bellTanTan/pc8031fabgl/img/022.jpg

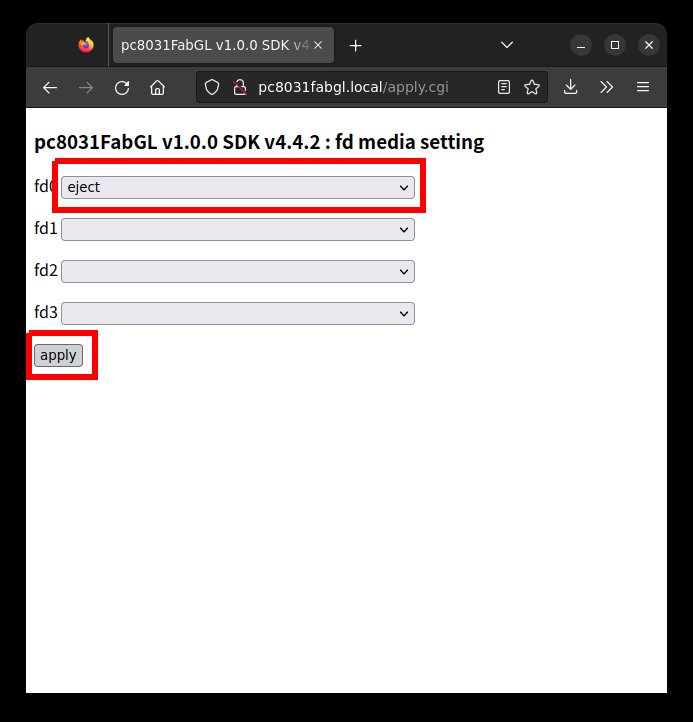
img/022.jpg
