bellTanTan/pc8031fabgl/src/machine.h

/*
  Created by tan (trinity09181718@gmail.com)
  Copyright (c) 2022 tan
  All rights reserved.

  This program is based on FabGL/examples/VGA/Altair8800/src/machine.h and
  FabGL/examples/VGA/PCEmulator/machine.h
  (http://www.fabglib.org/)

* Please contact trinity09181718@gmail.com if you need a commercial license.
* This software is available under GPL v3.

* This library and related software is available under GPL v3.

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
  You should have received a copy of the GNU General Public License
  along with FabGL.  If not, see <http://www.gnu.org/licenses/>.
 */


#pragma once

#include <stdint.h>
#include <stdio.h>
#include <string.h>
#include <time.h>
#include <utime.h>
#include <sys/time.h>
#include <sys/utime.h>
#include <WiFi.h>
#include <WiFiClient.h>
#include <WebServer.h>
#include <ESPmDNS.h>

#include "freertos/FreeRTOS.h"
#include "freertos/task.h"
#include "esp_int_wdt.h"

#include "fabgl.h"
#include "fabutils.h"
#include "emudevs/Z80.h"

using namespace fabgl;

#include "emu.h"
#include "version.h"
#include "DISK.h"

extern  WebServer     webServer;
extern  void webHandleRoot( void );
extern  void webHandleApply( void );
extern  void webHandleNotFound( void );


////////////////////////////////////////////////////////////////////////////////////
// Machine


class Machine
{
public:
  typedef struct {
    char *  name;
    time_t  tLastWrite;
  } DIRLIST , *PDIRLIST;

  Machine();

  ~Machine();

  int init( void );
  void initShiftInOut( void );
  void initWifi( void );
  void backGround( void );

  bool getDiskRomEnable( void )               { return m_diskRomEnable; }
  bool get2kRomLoaded( void )                 { return m_DISK.get2kRomLoaded(); }
  void shiftOutput( uint16_t value )          { m_DISK.shiftOutput( value ); }

  void setFdSettingComplete( void )
  {
    m_wifiTimer         = millis();
    m_wifiStatusLed     = HIGH;
    m_ledFlickerCount   = 20;
    m_fdSettingComplete = true;
  }

  bool setDiskImage( int drive, bool writeProtected, const char * imgFileName );
  const char * getDiskImageFileName( int drive );  

  void outputSystemStatusLed( int value );
  void eventWebHandleRoot( void );
  bool eventWebHandleApply( void );
  void eventWebHandleNotFound( void );

  void outputBootMessage( void )
  {
    _MSG_PRINT( "\r\nboot\r\n%s\r\n", m_version );
#ifdef ESP_ARDUINO_VERSION
    _MSG_PRINT( "ESP_ARDUINO_VERSION(0x%04X)\r\n", ESP_ARDUINO_VERSION );
#endif // ESP_ARDUINO_VERSION
    _MSG_PRINT( "FABGL_ESP_IDF_VERSION(0x%04X)\r\n", FABGL_ESP_IDF_VERSION );
  }

  void outputFreeHeapMessage( void )
  {
    _MSG_PRINT( "Internal Total Heap %d bytes\r\n", ESP.getHeapSize() );
    _MSG_PRINT( "Internal Free  Heap %d bytes\r\n", ESP.getFreeHeap() );
  }

private:
  void wifiMain( void );
  void checkWifiRssi( void );
  bool listDir( void );
  void freeDir( void );
  static int qsortComp( const void * p0, const void * p1 );
#ifdef _USED_SPIFFS
  bool updateSpiffsFileDateTime( void );
  time_t getFileDateTime( uint8_t * binBuf, const char * pszPath );
#endif // _USED_SPIFFS

#ifdef _DEBUG
  void debugHelp( void );
  void debugCommand( void );
#endif // _DEBUG

  SoundGenerator  m_soundGenerator;         // fabgl library : class SoundGenerator
                                            // floppy disk 0 ~ 3 image file name (*.D88)
  char            m_fdImgFileName[MAX_DRIVE][256];
  bool            m_diskRomEnable;          // flag : floppy disk rom enable
  DISK            m_DISK;                   // PC-80S31 (=PC-8801mkII SR/FR DISK.ROM 2Kbytes)

#ifdef _DEBUG
  char            m_serialRecvBuf[64];      // debug command Serial recive buffer
  int             m_serialRecvIndex;        // debug command Serial recive buffer index
  int             m_lastDumpDiskIoInAdrs;   // debug command Floppy DISK uint I/O input port last adderss
  int             m_lastDumpDiskIoOutAdrs;  // debug command Floppy DISK uint I/O output port last adderss
  int             m_lastDumpDiskMemoryAdrs; // debug command Floppy DISK uint Memory dump last adderss
  QueueHandle_t   m_queueHandle;            // queue handle
#endif // _DEBUG

  int             m_diskDirListCount;       // d88 file list count
  PDIRLIST        m_diskDirList;            // d88 file list

  int             m_wifiSeqNo;              // wifi sequence no
  int             m_wifiStatusLed;          // wifi led status
  int             m_wifiConnectCheckCnt;    // wifi connect check counter
  int             m_wifiTimer;              // wifi connect check timer
  int             m_ledFlickerCount;        // system status led flicker count
  bool            m_fdSettingComplete;      // flag : fd setting complete

  char            m_version[64];            // version
};
