bellTanTan/pc8031fabgl/src/media.cpp

/*
  Created by tan (trinity09181718@gmail.com)
  Copyright (c) 2022-2023 tan
  All rights reserved.

* Please contact trinity09181718@gmail.com if you need a commercial license.
* This software is available under GPL v3.

* This library and related software is available under GPL v3.

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
  You should have received a copy of the GNU General Public License
  along with FabGL.  If not, see <http://www.gnu.org/licenses/>.
 */

#include "media.h"


media::media()
{
  m_d88Type        = false;
  m_writeProtected = false;
  m_inserted       = false;
  m_mediaType      = MEDIA_TYPE_UNKNOWN;
  m_driveMfm       = false;
  m_fileSize       = 0;
  m_sectorSize     = 0;
  m_deleted        = false;
  m_crcError       = false;
  m_driveMfm       = false;

  m_d88FileHeader = NULL;
  m_d88rwBuffer   = NULL;
  m_sectorBuffer  = NULL;
  m_formatData    = NULL;
  m_formatMemSize = 0;
  m_formatSeekPos = 0;

  memset( m_imgFileName,  0, sizeof( m_imgFileName ) );
}


media::~media()
{
}


bool media::setSectorBuffer( uint8_t * d88rwBuffer )
{
  m_d88rwBuffer  = d88rwBuffer;
  m_sectorBuffer = &m_d88rwBuffer[16];
  size_t size = sizeof( *m_d88FileHeader );
  m_d88FileHeader = (PD88_FILE_HEADER)malloc( size );
  if ( !m_d88FileHeader ) return false;
  memset( m_d88FileHeader, 0, size );
  return true;
}


bool media::insert( bool writeProtected, const char * imgFileName )
{
  m_d88Type        = false;
  m_writeProtected = false;
  m_inserted       = false;
  m_mediaType      = MEDIA_TYPE_UNKNOWN;
  m_driveMfm       = false;
  m_fileSize       = 0;
  m_sectorSize     = 0;
  m_deleted        = false;
  m_crcError       = false;
  m_driveMfm       = false;
  if ( !imgFileName ) return false;
  memset( m_d88FileHeader, 0, sizeof( *m_d88FileHeader ) );
  char * p = strrchr( imgFileName, '.' );
  if ( !p ) return false;
  if ( strcasecmp( p, D88_FILE_EXTENSION ) != 0 ) return false;
  auto fp = fopen( imgFileName, "r" );
  if ( !fp ) return false;
  fseek( fp, 0, SEEK_END );
  size_t fileSize = ftell( fp );
  fseek( fp, 0, SEEK_SET );
  size_t result = fread( m_d88FileHeader, 1, sizeof( *m_d88FileHeader ), fp );
  fclose( fp );
  if ( result != sizeof( *m_d88FileHeader ) ) return false;
  if ( m_d88FileHeader->diskType != MEDIA_TYPE_2D ) return false;
  if ( m_d88FileHeader->diskSize != 348848 ) return false;
  if ( fileSize != 348848 ) return false;
  memset( m_imgFileName, 0, sizeof( m_imgFileName ) );
  strcpy( m_imgFileName, imgFileName );
  if ( m_d88FileHeader->writeProtect )
    m_writeProtected = true;
  else
    m_writeProtected = writeProtected;
  m_d88Type    = true;
  m_inserted   = true;
  m_ejected    = false;
  m_mediaType  = MEDIA_TYPE_2D;
  m_driveMfm   = true;
  m_fileSize   = fileSize;
  m_sectorSize = 256;
  m_deleted    = false;
  m_crcError   = false;
  return true;
}


void media::eject( void )
{
  m_d88Type        = false;
  m_inserted       = false;
  m_ejected        = true;
  m_writeProtected = false;
  m_mediaType      = MEDIA_TYPE_UNKNOWN;
  m_driveMfm       = false;
  m_fileSize       = 0;
  m_sectorSize     = 0;
  m_deleted        = false;
  m_crcError       = false;
  memset( m_imgFileName, 0, sizeof( m_imgFileName ) );
}


bool media::readSector( int cylinder, int head, int sectorNo, int sectorLen )
{
  if ( !( m_d88Type && m_inserted && m_mediaType == MEDIA_TYPE_2D && sectorLen == 1 ) ) return false;
  if ( !( cylinder >= 0 && cylinder <= 39 ) ) return false;
  if ( !( head >= 0 && head <= 1 ) )          return false;
  if ( !( sectorNo >= 1 && sectorNo <= 16 ) ) return false;
  int d88SectorSize = 16 + m_sectorSize;
  int logicalTrack = ( cylinder * 2 ) + head;
  int seekPos = sizeof( D88_FILE_HEADER )
              + ( d88SectorSize * 16 * logicalTrack )
              + ( d88SectorSize * ( sectorNo - 1 ) );
  int sectorPos = m_d88FileHeader->trackTable[cylinder]
                + ( d88SectorSize * 16 * cylinder )
                + ( d88SectorSize * 16 * head )
                + ( d88SectorSize * ( sectorNo - 1 ) );
  if ( seekPos != sectorPos ) return false;
  if ( seekPos > m_fileSize ) return false;
  auto fp = fopen( m_imgFileName, "r" );
  if ( !fp ) return false;
  bool sectorRead = false;
  fseek( fp, seekPos, SEEK_SET );
  size_t result = fread( &m_d88rwBuffer[0], 1, d88SectorSize, fp );
  if ( result == d88SectorSize )
    sectorRead = true;
  else
    m_crcError = true;
  fclose( fp );
  return sectorRead;
}


bool media::writeSector( int cylinder, int head, int sectorNo, int sectorLen )
{
  if ( !( m_d88Type && m_inserted && m_mediaType == MEDIA_TYPE_2D && sectorLen == 1 ) ) return false;
  if ( !( cylinder >= 0 && cylinder <= 39 ) ) return false;
  if ( !( head >= 0 && head <= 1 ) )          return false;
  if ( !( sectorNo >= 1 && sectorNo <= 16 ) ) return false;
  int d88SectorSize = 16 + m_sectorSize;
  int logicalTrack = ( cylinder * 2 ) + head;
  int seekPos = sizeof( D88_FILE_HEADER )
              + ( d88SectorSize * 16 * logicalTrack )
              + ( d88SectorSize * ( sectorNo - 1 ) );
  int sectorPos = m_d88FileHeader->trackTable[cylinder]
                + ( d88SectorSize * 16 * cylinder )
                + ( d88SectorSize * 16 * head )
                + ( d88SectorSize * ( sectorNo - 1 ) );
  if ( seekPos != sectorPos ) return false;
  if ( seekPos > m_fileSize ) return false;
  auto fp = fopen( m_imgFileName, "r+" );
  if ( !fp ) return false;
  bool sectorWrite = false;
  fseek( fp, seekPos, SEEK_SET );
  size_t result = fwrite( &m_d88rwBuffer[0], 1, d88SectorSize, fp );
  if ( result == d88SectorSize )
    sectorWrite = true;
  else
    m_crcError = true;
  fclose( fp );
  return sectorWrite;
}


bool media::formatTrackBegin( int cylinder, int head, int sectorNoMax )
{
  if ( !( m_d88Type && m_inserted && m_mediaType == MEDIA_TYPE_2D && sectorNoMax == 16 ) ) return false;
  if ( !( cylinder >= 0 && cylinder <= 39 ) ) return false;
  if ( !( head >= 0 && head <= 1 ) )          return false;
  if ( !m_formatData )
  {
    m_formatMemSize = (16 + 256) * sectorNoMax;
    m_formatData = (uint8_t *)malloc( m_formatMemSize );
    if ( !m_formatData )
    {
      _UPD765A_DEBUG_PRINT( "uPD765A %s(%d) malloc(%d) fail\r\n", __func__, __LINE__, m_formatMemSize );
      return false;
    }
  }
  m_formatSeekPos = 0;
  _UPD765A_DEBUG_PRINT( "uPD765A %s(%d) '%s'\r\n", __func__, __LINE__, m_imgFileName );
  return true;
}


void media::formatTrackEnd( void )
{
  if ( m_formatMemSize == 0 || m_formatSeekPos == 0 )
    return;
#ifdef _UPD765A_DEBUG
  uint32_t t0 = micros();
#endif // _UPD765A_DEBUG
  auto fp = fopen( m_imgFileName, "r+" );
  if ( !fp ) return;
  fseek( fp, m_formatSeekPos, SEEK_SET );
  size_t result = fwrite( m_formatData, 1, m_formatMemSize, fp );
  if ( result != m_formatMemSize )
    _UPD765A_DEBUG_PRINT( "uPD765A %s(%d) fwrite fail\r\n", __func__, __LINE__ );
  fclose( fp );
#ifdef _UPD765A_DEBUG
  uint32_t t1 = micros();
  int dt = t1 - t0;
  _UPD765A_DEBUG_PRINT( "uPD765A %s(%d) %d msec(%d usec)\r\n", __func__, __LINE__, dt / 1000, dt );
#endif // _UPD765A_DEBUG
}


bool media::formatSector( int cylinder, int head, int sectorNo, int sectorLen, int eot, uint8_t fillData, int length )
{
  if ( !( m_d88Type && m_inserted && m_mediaType == MEDIA_TYPE_2D && sectorLen == 1 ) ) return false;
  if ( !( cylinder >= 0 && cylinder <= 39 ) ) return false;
  if ( !( head >= 0 && head <= 1 ) )          return false;
  if ( !( sectorNo >= 1 && sectorNo <= 16 ) ) return false;
  if ( !( length == m_sectorSize ) )          return false;
  int d88SectorSize = 16 + m_sectorSize;
  int logicalTrack = ( cylinder * 2 ) + head;
  if ( !m_formatData ) return false;
  int seekPos = sizeof( D88_FILE_HEADER )
                + ( d88SectorSize * 16 * logicalTrack )
                + ( d88SectorSize * ( sectorNo - 1 ) );
  int sectorPos = m_d88FileHeader->trackTable[cylinder]
                  + ( d88SectorSize * 16 * cylinder )
                  + ( d88SectorSize * 16 * head )
                  + ( d88SectorSize * ( sectorNo - 1 ) );
  if ( seekPos != sectorPos ) return false;
  if ( seekPos > m_fileSize ) return false;
  if ( m_formatSeekPos == 0 )
    m_formatSeekPos = seekPos;
  int offset = (16 + 256) * ( sectorNo - 1 );
  PD88_FILE_SECTOR pD88SectorHead = (PD88_FILE_SECTOR)&m_formatData[offset];
  pD88SectorHead->cylinder       = cylinder;
  pD88SectorHead->head           = head;
  pD88SectorHead->sector         = sectorNo;
  pD88SectorHead->sectorSize     = 1;
  pD88SectorHead->numberOfSector = eot;
  pD88SectorHead->density        = 0x00;  // 0x00 : double density
  pD88SectorHead->deletedMark    = 0x00;  // 0x00 : normal
  pD88SectorHead->status         = 0x00;  // 0x00 : normal
  pD88SectorHead->reserve[0]     = 0x00;
  pD88SectorHead->reserve[1]     = 0x00;
  pD88SectorHead->reserve[2]     = 0x00;
  pD88SectorHead->reserve[3]     = 0x00;
  pD88SectorHead->reserve[4]     = 0x00;
  pD88SectorHead->sizeOfData     = length;
  memset( &m_formatData[offset+16], fillData, m_sectorSize );
  return true;
}


void media::setDeleted( bool value )
{
  if ( m_d88rwBuffer != NULL )
  {
    PD88_FILE_SECTOR d88FileSector = (PD88_FILE_SECTOR)m_d88rwBuffer;
    d88FileSector->deletedMark = value ? 0x10 : 0x00;
    if ( ( d88FileSector->status & 0xF0 ) == 0x00
      || ( d88FileSector->status & 0xF0 ) == 0x10 )
      d88FileSector->status = ( d88FileSector->status & 0x0F ) | d88FileSector->deletedMark;
  }
  m_deleted = value;
}
