bellTanTan/pc8031fabgl/(commit log)

2022-12-19 v1.0.1
    オーディオ出力回路間違い修正
    Wi-Fi接続後に接続断検出後の復帰シーケンスでメモリーリーク発生するのを改修
2023-02-18 v1.0.2
    write_idコマンド処理(format)速度改善。spiffsマウント対応。
2023-04-16 v1.0.3
    format(write_id)で.d88のsectorSizeフィールドが0x00になっていた不具合改修。
